ggr8/GR8RAM/GR8RAM.kicad_pcb

## KiCad design GR8RAM.kicad_pcb (2021-04-11)

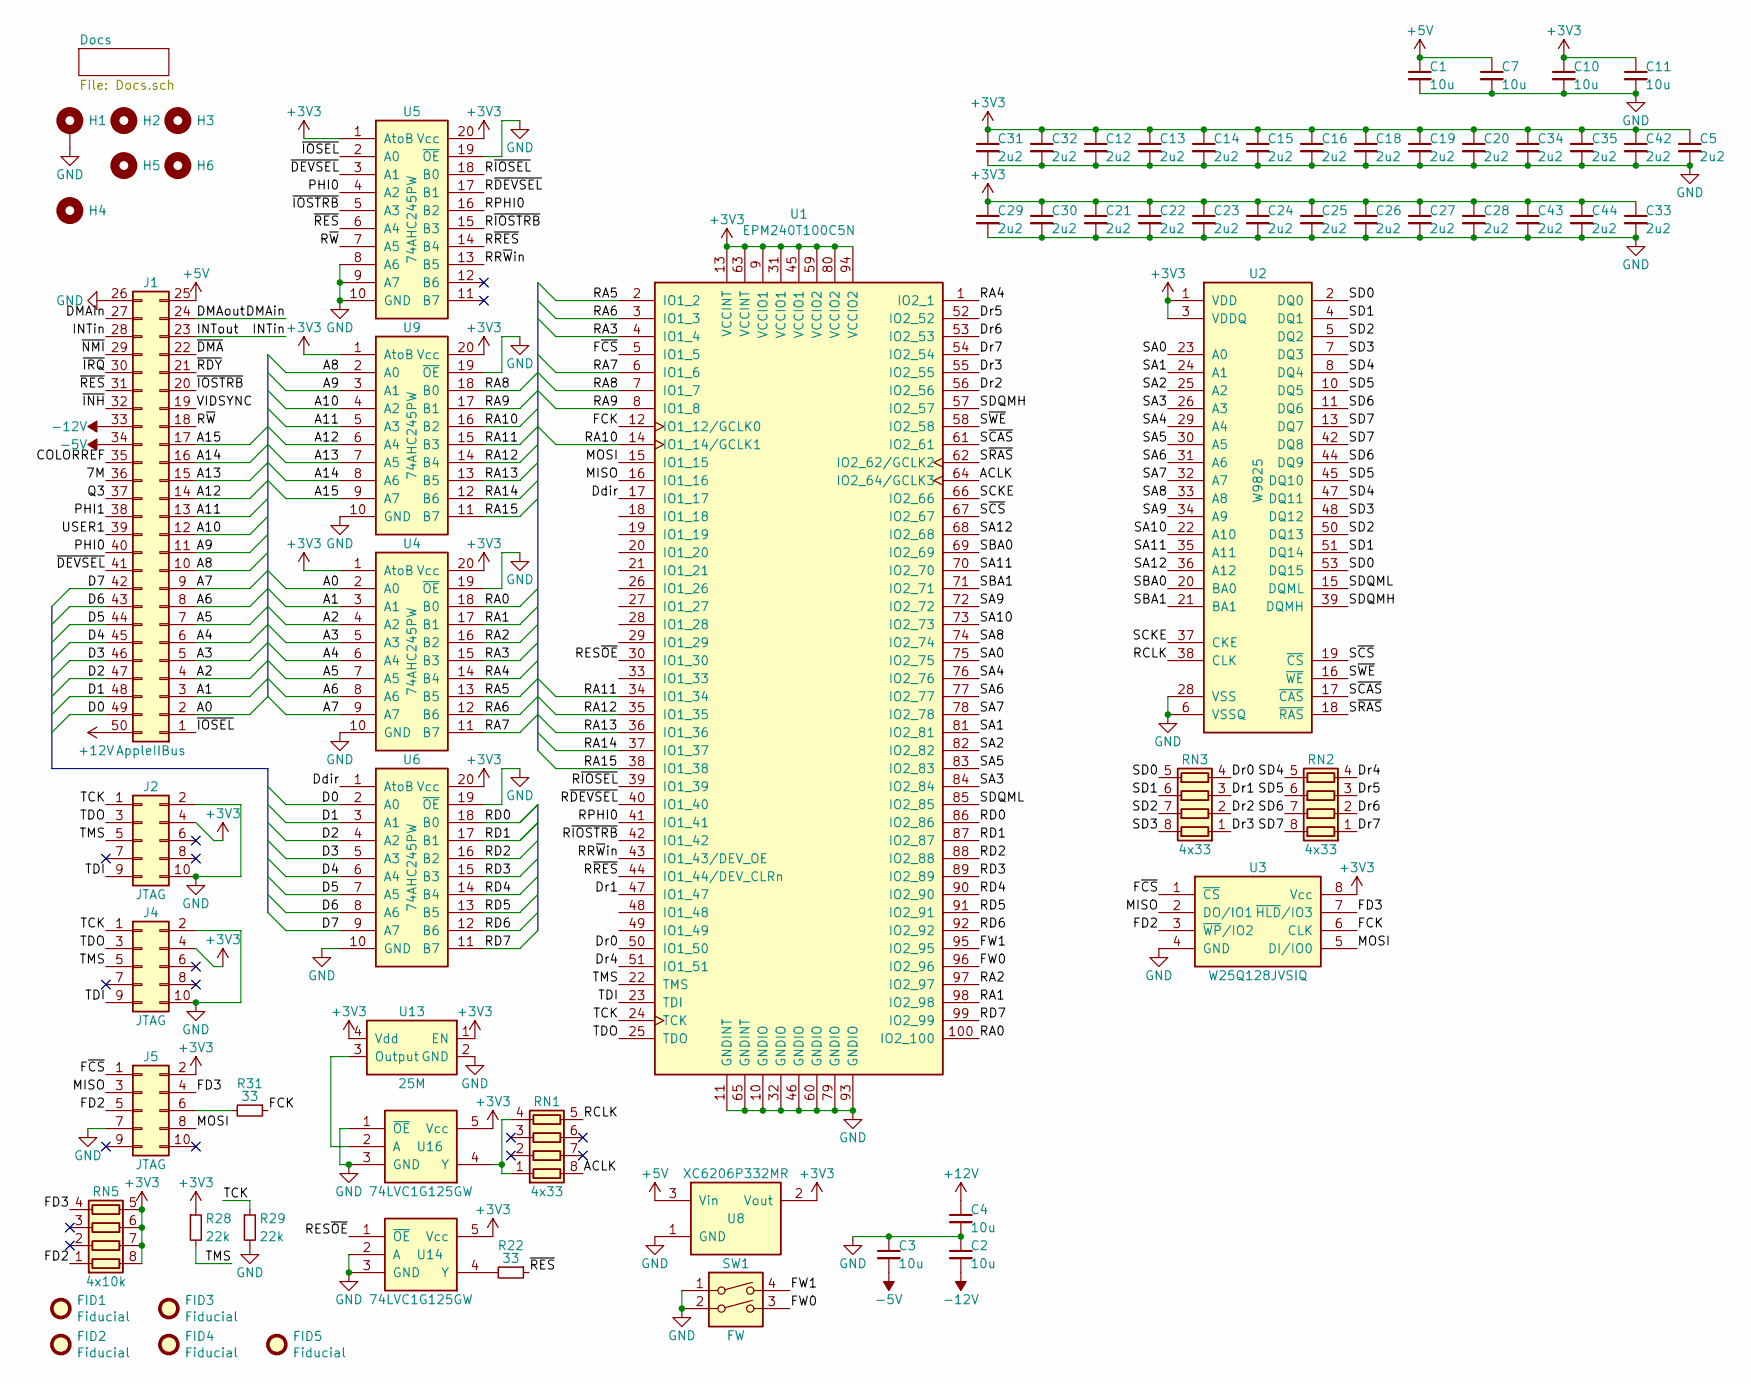
[picture p2: schematic GR8RAM.sch]

Parts:
C1, C2, C3, C4, C7, C10, C11: 10u; C_0805; LCSC Part C15850
C5, C12, C13, C14, C15, C16, C18, C19, C20, C21, C22, C23, C24, C25, C26, C27, C28, C29, C30, C31, C32, C33, C34, C35, C42, C43, C44: 2u2; C_0603; LCSC Part C23630
FID1, FID2, FID3, FID4, FID5: Fiducial
H1: PasteHole_1.1mm_PTH
H2, H3, H4, H5, H6: PasteHole_1.152mm_NPTH
J1: AppleIIBus; AppleIIBus_Edge
J2, J5: JTAG; Tag-Connect_TC2050-IDC-FP_2x05_P1.27mm_Vertical
J4: JTAG; IDC-Header_2x05_P2.54mm_Vertical
R22, R31: 33; R_0603; LCSC Part C23140
R28, R29: 22k; R_0603; LCSC Part C31850
RN1, RN2, RN3: 4x33; R4_0402; LCSC Part C25501
RN5: 4x10k; R4_0402; LCSC Part C25725
SW1: FW; SW_DIP_SPSTx02_Slide_DSHP02TS_P1.27mm; LCSC Part C319052
U1: EPM240T100C5N; TQFP-100_14x14mm_P0.5mm; LCSC Part C10041
U2: W9825; TSOP-II-54_22.2x10.16mm_P0.8mm; LCSC Part C62246
U3: W25Q128JVSIQ; SOIC-8_5.3mm; LCSC Part C164122
U4, U5, U6, U9: 74AHC245PW; TSSOP-20_4.4x6.5mm_P0.65mm; LCSC Part C5516
U8: XC6206P332MR; SOT-23; LCSC Part C5446
U13: 25M; Crystal_SMD_3225-4Pin_3.2x2.5mm; LCSC Part C669088
U14, U16: 74LVC1G125GW; SOT-353; LCSC Part C12519

Connections:
+3V3: C5.1, C10.1, C11.1, C12.1, C13.1, C14.1, C15.1, C16.1, C18.1, C19.1, C20.1, C21.1, C22.1, C23.1, C24.1, C25.1, C26.1, C27.1, C28.1, C29.1, C30.1, C31.1, C32.1, C33.1, C34.1, C35.1, C42.1, C43.1, C44.1, J2.4, J4.4, J5.2, R28.1, RN5.5 (R4.2), RN5.6 (R3.2), RN5.7 (R2.2), RN5.8 (R1.2), U1.9 (VCCIO1), U1.13 (VCCINT), U1.31 (VCCIO1), U1.45 (VCCIO1), U1.59 (VCCIO2), U1.63 (VCCINT), U1.80 (VCCIO2), U1.94 (VCCIO2), U2.1 (VDD), U2.3 (VDDQ), U2.9 (VDDQ), U2.14 (VDD), U2.27 (VDD), U2.43 (VDDQ), U2.49 (VDDQ), U3.8 (Vcc), U4.1 (AtoB), U4.20 (Vcc), U5.1 (AtoB), U5.20 (Vcc), U6.20 (Vcc), U8.2 (Vout), U9.1 (AtoB), U9.20 (Vcc), U13.1 (EN), U13.4 (Vdd), U14.5 (Vcc), U16.5 (Vcc)
+5V: C1.1, C7.1, J1.25, U8.3 (Vin)
+12V: C4.1, J1.50
-5V: C3.2, J1.34
-12V: C2.2, J1.33
/7M: J1.36
/A0: J1.2, U4.2 (A0)
/A1: J1.3, U4.3 (A1)
/A2: J1.4, U4.4 (A2)
/A3: J1.5, U4.5 (A3)
/A4: J1.6, U4.6 (A4)
/A5: J1.7, U4.7 (A5)
/A6: J1.8, U4.8 (A6)
/A7: J1.9, U4.9 (A7)
/A8: J1.10, U9.2 (A0)
/A9: J1.11, U9.3 (A1)
/A10: J1.12, U9.4 (A2)
/A11: J1.13, U9.5 (A3)
/A12: J1.14, U9.6 (A4)
/A13: J1.15, U9.7 (A5)
/A14: J1.16, U9.8 (A6)
/A15: J1.17, U9.9 (A7)
/ACLK: RN1.8 (R1.2), U1.64 (IO2_64/GCLK3)
/COLORREF: J1.35
/D0: J1.49, U6.2 (A0)
/D1: J1.48, U6.3 (A1)
/D2: J1.47, U6.4 (A2)
/D3: J1.46, U6.5 (A3)
/D4: J1.45, U6.6 (A4)
/D5: J1.44, U6.7 (A5)
/D6: J1.43, U6.8 (A6)
/D7: J1.42, U6.9 (A7)
/DMAin: J1.24, J1.27
/Ddir: U1.17 (IO1_17), U6.1 (AtoB)
/Dr0: RN3.4 (R4.1), U1.50 (IO1_50)
/Dr1: RN3.3 (R3.1), U1.47 (IO1_47)
/Dr2: RN3.2 (R2.1), U1.56 (IO2_56)
/Dr3: RN3.1 (R1.1), U1.55 (IO2_55)
/Dr4: RN2.4 (R4.1), U1.51 (IO1_51)
/Dr5: RN2.3 (R3.1), U1.52 (IO2_52)
/Dr6: RN2.2 (R2.1), U1.53 (IO2_53)
/Dr7: RN2.1 (R1.1), U1.54 (IO2_54)
/FCK: R31.1, U1.12 (IO1_12/GCLK0), U3.6 (CLK)
/FD2: J5.5, RN5.1 (R1.1), U3.3 (~WP~/IO2)
/FD3: J5.4, RN5.4 (R4.1), U3.7 (~HLD~/IO3)
/FW0: SW1.3, U1.96 (IO2_96)
/FW1: SW1.4, U1.95 (IO2_95)
/F~CS~: J5.1, U1.5 (IO1_5), U3.1 (~CS~)
/INTin: J1.23, J1.28
/MISO: J5.3, U1.16 (IO1_16), U3.2 (DO/IO1)
/MOSI: J5.8, U1.15 (IO1_15), U3.5 (DI/IO0)
/PHI0: J1.40, U5.4 (A2)
/PHI1: J1.38
/Q3: J1.37
/RA0: U1.100 (IO2_100), U4.18 (B0)
/RA1: U1.98 (IO2_98), U4.17 (B1)
/RA2: U1.97 (IO2_97), U4.16 (B2)
/RA3: U1.4 (IO1_4), U4.15 (B3)
/RA4: U1.1 (IO2_1), U4.14 (B4)
/RA5: U1.2 (IO1_2), U4.13 (B5)
/RA6: U1.3 (IO1_3), U4.12 (B6)
/RA7: U1.6 (IO1_6), U4.11 (B7)
/RA8: U1.7 (IO1_7), U9.18 (B0)
/RA9: U1.8 (IO1_8), U9.17 (B1)
/RA10: U1.14 (IO1_14/GCLK1), U9.16 (B2)
/RA11: U1.34 (IO1_34), U9.15 (B3)
/RA12: U1.35 (IO1_35), U9.14 (B4)
/RA13: U1.36 (IO1_36), U9.13 (B5)
/RA14: U1.37 (IO1_37), U9.12 (B6)
/RA15: U1.38 (IO1_38), U9.11 (B7)
/RCLK: RN1.5 (R4.2), U2.38 (CLK)
/RD0: U1.86 (IO2_86), U6.18 (B0)
/RD1: U1.87 (IO2_87), U6.17 (B1)
/RD2: U1.88 (IO2_88), U6.16 (B2)
/RD3: U1.89 (IO2_89), U6.15 (B3)
/RD4: U1.90 (IO2_90), U6.14 (B4)
/RD5: U1.91 (IO2_91), U6.13 (B5)
/RD6: U1.92 (IO2_92), U6.12 (B6)
/RD7: U1.99 (IO2_99), U6.11 (B7)
/RES~OE~: U1.30 (IO1_30), U14.1 (~OE~)
/RPHI0: U1.41 (IO1_41), U5.16 (B2)
/RR~W~in: U1.43 (IO1_43/DEV_OE), U5.13 (B5)
/R~DEVSEL~: U1.40 (IO1_40), U5.17 (B1)
/R~IOSEL~: U1.39 (IO1_39), U5.18 (B0)
/R~IOSTRB~: U1.42 (IO1_42), U5.15 (B3)
/R~RES~: U1.44 (IO1_44/DEV_CLRn), U5.14 (B4)
/R~W~: J1.18, U5.7 (A5)
/SA0: U1.75 (IO2_75), U2.23 (A0)
/SA1: U1.81 (IO2_81), U2.24 (A1)
/SA2: U1.82 (IO2_82), U2.25 (A2)
/SA3: U1.84 (IO2_84), U2.26 (A3)
/SA4: U1.76 (IO2_76), U2.29 (A4)
/SA5: U1.83 (IO2_83), U2.30 (A5)
/SA6: U1.77 (IO2_77), U2.31 (A6)
/SA7: U1.78 (IO2_78), U2.32 (A7)
/SA8: U1.74 (IO2_74), U2.33 (A8)
/SA9: U1.72 (IO2_72), U2.34 (A9)
/SA10: U1.73 (IO2_73), U2.22 (A10)
/SA11: U1.70 (IO2_70), U2.35 (A11)
/SA12: U1.68 (IO2_68), U2.36 (A12)
/SBA0: U1.69 (IO2_69), U2.20 (BA0)
/SBA1: U1.71 (IO2_71), U2.21 (BA1)
/SCKE: U1.66 (IO2_66), U2.37 (CKE)
/SD0: RN3.5 (R4.2), U2.2 (DQ0), U2.53 (DQ15)
/SD1: RN3.6 (R3.2), U2.4 (DQ1), U2.51 (DQ14)
/SD2: RN3.7 (R2.2), U2.5 (DQ2), U2.50 (DQ13)
/SD3: RN3.8 (R1.2), U2.7 (DQ3), U2.48 (DQ12)
/SD4: RN2.5 (R4.2), U2.8 (DQ4), U2.47 (DQ11)
/SD5: RN2.6 (R3.2), U2.10 (DQ5), U2.45 (DQ10)
/SD6: RN2.7 (R2.2), U2.11 (DQ6), U2.44 (DQ9)
/SD7: RN2.8 (R1.2), U2.13 (DQ7), U2.42 (DQ8)
/SDQMH: U1.57 (IO2_57), U2.39 (DQMH)
/SDQML: U1.85 (IO2_85), U2.15 (DQML)
/S~CAS~: U1.61 (IO2_61), U2.17 (~CAS~)
/S~CS~: U1.67 (IO2_67), U2.19 (~CS~)
/S~RAS~: U1.62 (IO2_62/GCLK2), U2.18 (~RAS~)
/S~WE~: U1.58 (IO2_58), U2.16 (~WE~)
/TCK: J2.1, J4.1, R29.1, U1.24 (TCK)
/TDI: J2.9, J4.9, U1.23 (TDI)
/TDO: J2.3, J4.3, U1.25 (TDO)
/TMS: J2.5, J4.5, R28.2, U1.22 (TMS)
/USER1: J1.39
/VIDSYNC: J1.19
/~DEVSEL~: J1.41, U5.3 (A1)
/~DMA~: J1.22
/~INH~: J1.32
/~IOSEL~: J1.1, U5.2 (A0)
/~IOSTRB~: J1.20, U5.5 (A3)
/~IRQ~: J1.30
/~NMI~: J1.29
/~RDY~: J1.21
/~RES~: J1.31, R22.1, U5.6 (A4)
GND: C1.2, C2.1, C3.1, C4.2, C5.2, C7.2, C10.2, C11.2, C12.2, C13.2, C14.2, C15.2, C16.2, C18.2, C19.2, C20.2, C21.2, C22.2, C23.2, C24.2, C25.2, C26.2, C27.2, C28.2, C29.2, C30.2, C31.2, C32.2, C33.2, C34.2, C35.2, C42.2, C43.2, C44.2, H1.1, J1.26, J2.2, J2.10, J4.2, J4.10, J5.7, R29.2, SW1.1, SW1.2, U1.10 (GNDIO), U1.11 (GNDINT), U1.32 (GNDIO), U1.46 (GNDIO), U1.60 (GNDIO), U1.65 (GNDINT), U1.79 (GNDIO), U1.93 (GNDIO), U2.6 (VSSQ), U2.12 (VSSQ), U2.28 (VSS), U2.41 (VSS), U2.46 (VSSQ), U2.52 (VSSQ), U2.54 (VSS), U3.4 (GND), U4.10 (GND), U4.19 (~OE~), U5.8 (A6), U5.9 (A7), U5.10 (GND), U5.19 (~OE~), U6.10 (GND), U6.19 (~OE~), U8.1 (GND), U9.10 (GND), U9.19 (~OE~), U13.2 (GND), U14.2 (A), U14.3 (GND), U16.1 (~OE~), U16.3 (GND)
unnamed: J5.6, R31.2
unnamed: R22.2, U14.4 (Y)
unnamed: RN1.1 (R1.1), RN1.4 (R4.1), U16.4 (Y)
unnamed: U13.3 (Output), U16.2 (A)

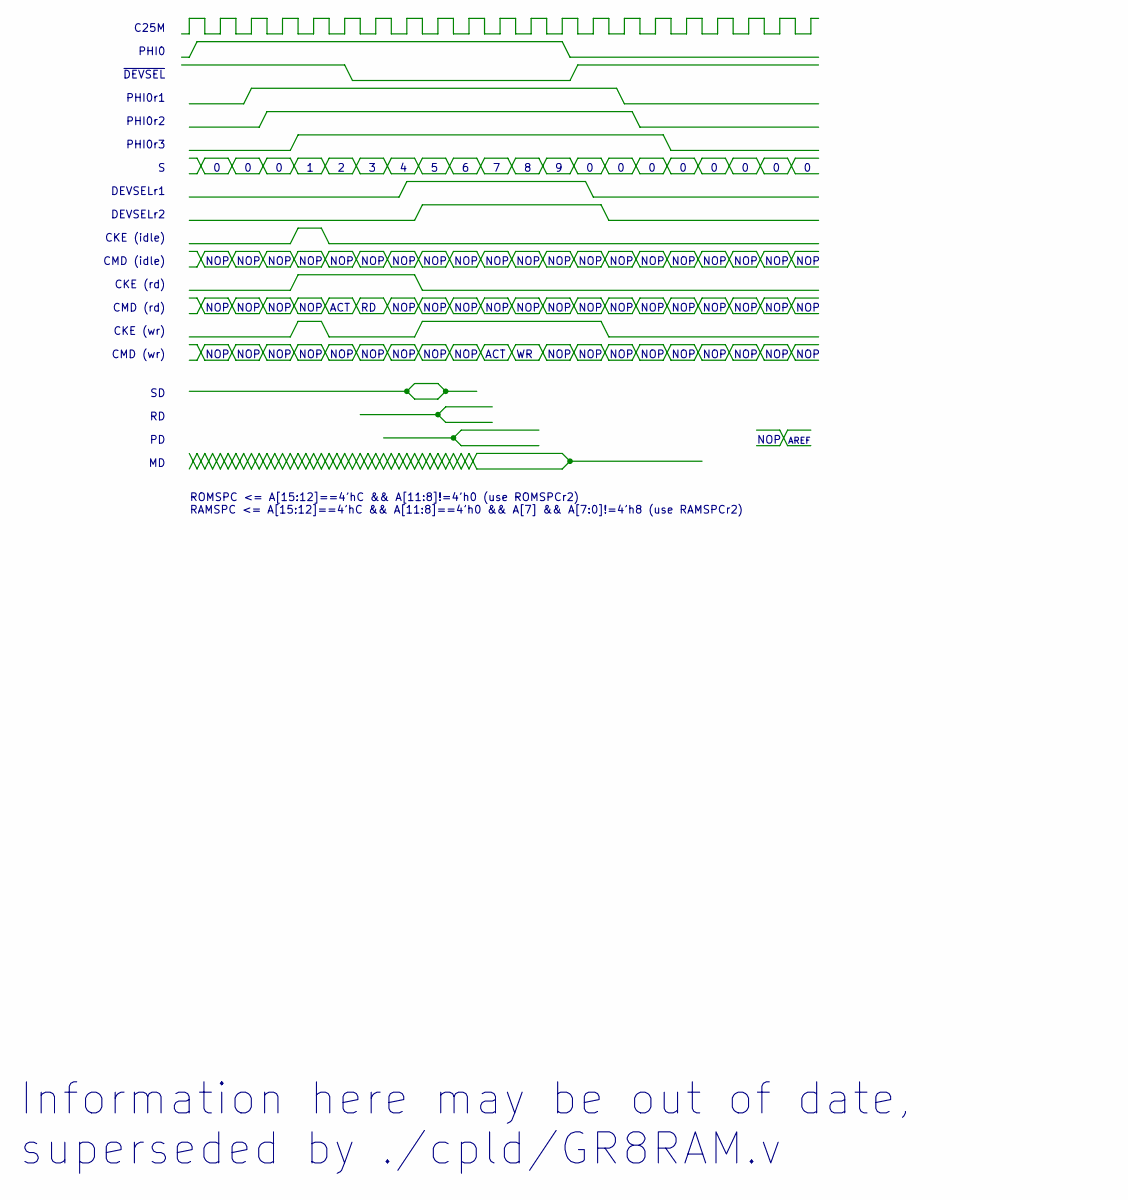
[picture p3: schematic Docs.sch, GR8RAM]

Notes on the sheet:
Information here may be out of date, superseded by ./cpld/GR8RAM.v
C25M
PHI0
~DEVSEL~
NOP
CKE (rd)
CMD (rd)
ACT
CMD (idle)
CKE (idle)
DEVSELr1
PHI0r3
PHI0r2
PHI0r1
CKE (wr)
CMD (wr)
ROMSPC <= A[15:12]==4’hC && A[11:8]!=4’h0 (use ROMSPCr2) RAMSPC <= A[15:12]==4’hC && A[11:8]==4’h0 && A[7] && A[7:0]!=4’h8 (use RAMSPCr2)
AREF
DEVSELr2

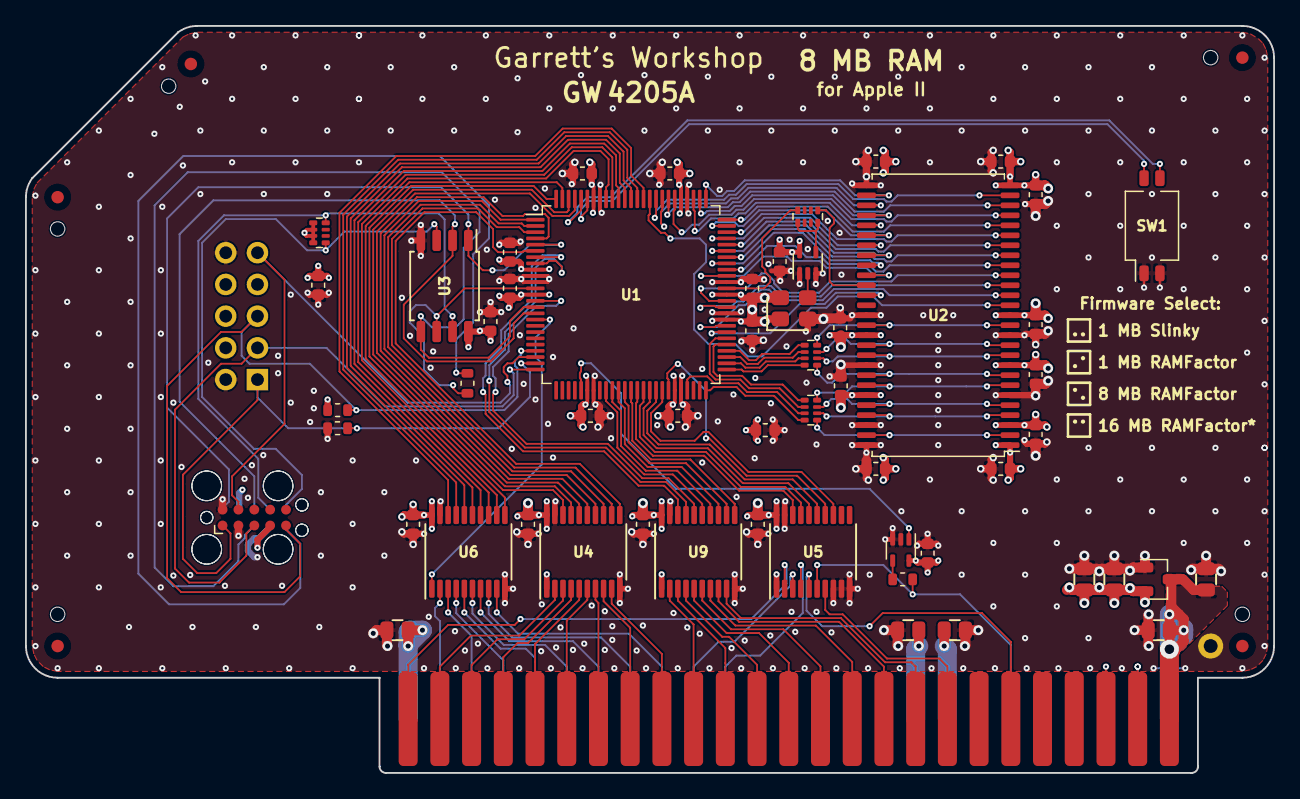
[picture p4: board GR8RAM.kicad_pcb from above]

Board: 4 copper layers, 99.9 x 59.8 mm, 69 parts (1 on the bottom side), 126 nets.
