ggr8/GR8RAM/(commit log)

2019-07-21 Release candidate PCB
    [GR8RAM-B_Cu.gbl, GR8RAM-B_Mask.gbs, GR8RAM-B_SilkS.gbo, GR8RAM-Edge_Cuts.gm1, GR8RAM-F_Cu.gtl, GR8RAM-F_Mask.gts, GR8RAM-F_Paste.gtp, GR8RAM-F_SilkS.gto]
2019-07-30 Submitted to JLCPCB
    [Docs.sch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]
2019-09-01 CPLD firmware compiles
    [Docs.sch, GR8RAM.sch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]
2019-09-02 1MB CPLD design seems to work, fails Apple BIST
    [GR8RAM.qsf, GR8RAM.v]
2019-09-02 Clarifications and bugfixes, will try again
    [Docs.sch, GR8RAM.sch]
2019-09-05 added some disassembly of RamFactor
    [Docs.sch]
2019-10-12 24-bit counter, CAS fixed
    [GR8RAM.qsf, GR8RAM.v]
2019-10-13 Put gerber files back
    [GR8RAM-B_Cu.gbl, GR8RAM-F_Cu.gtl, GR8RAM-F_Mask.gts, GR8RAM-F_Paste.gtp, GR8RAM-F_SilkS.gto]
2019-10-13 Register reset/initial values set syntax changed
    [GR8RAM.v]
2019-10-13 Removed old driver disassemblies
2019-10-13 New schematic revision
    [Docs.sch, GR8RAM.kicad_pcb, GR8RAM.sch]
2019-10-13 Switch library location, fixed datasheet fields
    [GR8RAM.sch]
2019-10-18 New PLD revision
    For write operations, register data is latched and CAS signal becomes in the middle of S6, 70ns before the end of PHI0. This gives more write data setup time, which may be needed on the Apple II with the 1 MHz 6502.
    [Docs.sch]
2019-10-21 Fixed bugs in new PLD stuff
    [GR8RAM.qsf, GR8RAM.v]
2019-12-21 Removed state counter reset
    [GR8RAM.v]
2020-01-26 Separated CSDBEN
    [Docs.sch]
2020-02-09 Removed AVR-JTAG-10 connector footprint
    [Docs.sch, GR8RAM.sch]
2020-02-16 Doesn't work but committing for posterity
    [GR8RAM.v]
2020-02-16 Fixed previous problem, working again
    [GR8RAM.v]
2020-10-08 Board done?
    [Docs.sch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]
2020-10-25 reset button detect
    [GR8RAM-BOM.csv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]
2024-05-12 Update gitignore -- remove lck and kicad_prl files
